JuperTronic/Jupertronic_Root_Commander/JuperTronic_Root_Commander_schem.pdf

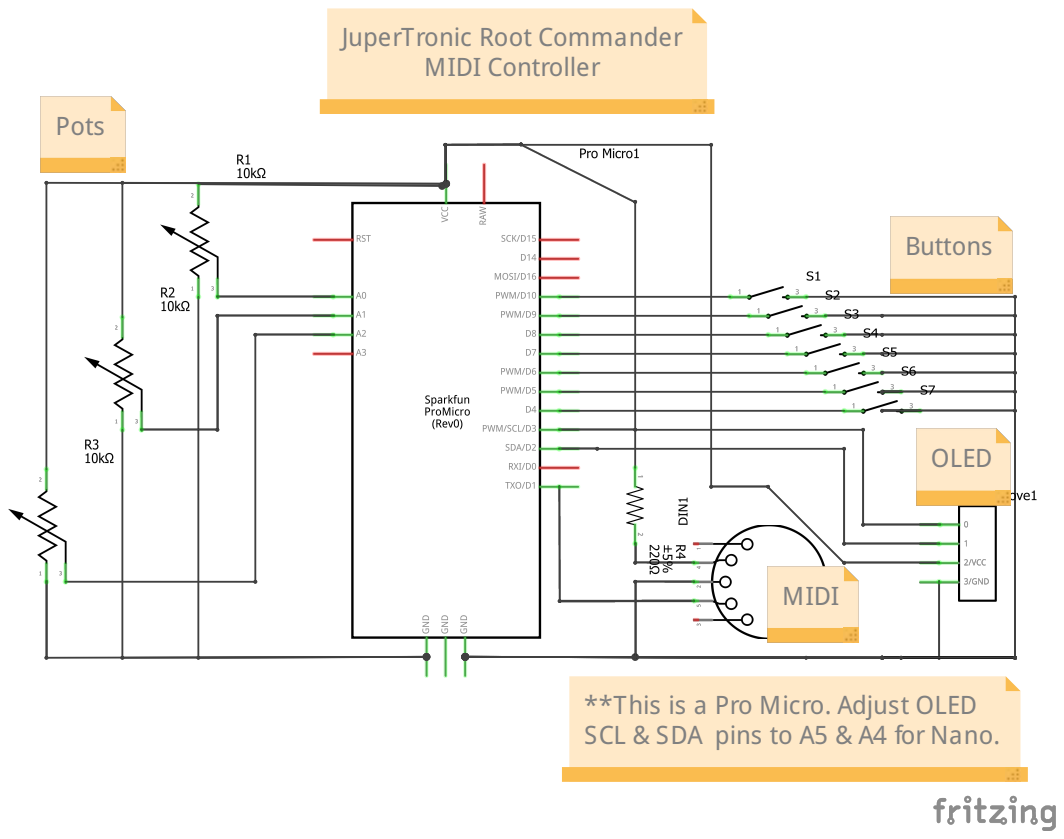
[picture p3: page 1]
MIDI Controller; OLED; Buttons; Pots; MIDI

JuperTronic Root Commander

**This is a Pro Micro. Adjust OLED
SCL & SDA pins to A5 & A4 for Nano.
