JuperTronic/Jupertronic_Root_Commander/(threads)

Thread 1 (2023-05-20):

Text out of screen

Wapata, 2023-05-20:
Hi there !
As the code is too big for Arduino Nano I've taken an Arduino Mega but... the text is way out of screen. But the screen seem to be in spec ( https://www.amazon.com/gp/product/B08KY21SR2 like).

In the end i will try to make a screenless device but hey... that a great project i wanted to try and i've tested it "nature" ;-)
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

Wapata, 2023-05-20:
Hi !
I've found out that it's line 171
`  oledWriteString(&ssoled, 0, 5, 0, (char *)nameScale, FONT_NORMAL, 0, 1);
`
that doesn't work on my side. I've commented it and uncomment the previous ones.

I suspect that it's not the last code on Github too (or libraries), because there is no space character after the "note" line 200 to 260 and the "b" character doesn't fade out this way .

Have a nice day !

tatronic, 2025-07-25:
Hello,
Yes, the  SSD1306Ascii library saved a lot of memory and was easy to use,
very similar to the OLED library you originally used with the Jupertronic
code.
I really like the 2D array in your code; scales[nScales][nRoots] is great,
very helpful.
(I used the map() function to set parameters (ranges) for the pot values,
but the way you did it worked well too).
Thanks for sharing your work, I sincerely appreciate it.

Tony

On Wed, Jul 23, 2025 at 9:44 AM Janis Wilson Hughes <
***@***.***> wrote:

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
