JuperTronic/Jupertronic_Root_Commander/(commit log)

2022-04-29 Circuit schematic added
2022-04-29 MIDI 5 Pin Schematic
2022-04-29 Circuit Schematic
2022-04-29 Arduino code
